ARTITULE/KivoPad/BOM.csv

Item | Qty | Supplier | Cost/item | Total Cost | link
PCB | 1 | JLCPCB | $10.80 | $10.80 | https://jlcpcb.com/
Components from LSCS(Please upload the PCB BOM to their website) | 1 | LSCS | $10.75(Estimated) | $10.75 | https://www.lcsc.com
500mAh Battery | 1 | Amazon | $8.99 | $8.99 | https://www.amazon.com/dp/B0CNLN7F24?_encoding=UTF8&th=1
NRF ProMicro | 1 | Amazon | $7.99 | $7.99 | https://www.amazon.com/NRF52840-Development-Bluetooth-Wireless-Electronics/dp/B0GSZ7FD6T
Estimated total shipping | 1 |  |  | $10.00
Estimated TOTAL |  |  |  | $48.53
