ARTITULE/KivoPad/PCB_FIles/BOM_KivoPad_v1.0.csv

No. | Quantity | Comment | Designator | Footprint | Value | Manufacturer Part | Manufacturer | Supplier Part | Supplier
1 | 4 | 100nF | C1,C2,C3,C4 | C0402 | 100nF | CL05B104KB54PNC | SAMSUNG(三星) | C307331 | LCSC
2 | 16 | 1N4148WS | D1,D2,D3,D4,D5,D6,D7,D8,D9,D10,D11,D12,D13,D14,D15,D16 | SOD-323_L1.8-W1.3-LS2.5-RD |  | 1N4148WS | JSMSEMI(杰盛微) | C917117 | LCSC
3 | 4 | Screw-Hole-M2 | M1,M2,M3,M4 | Screw-Hole-M2
4 | 3 | Screw-Hole-M3 | M5,M6,M7 | Screw-Hole-M3
5 | 4 | 5.1kΩ | R1,R2,R3,R4 | R0402 | 5.1kΩ | 0402WGF5101TCE | UNI-ROYAL(厚声) | C25905 | LCSC
6 | 1 | KMR221GLFS | SW1 | KEY-SMD_KMR2XXGXXX |  | KMR221GLFS | C&K | C72443 | LCSC
7 | 1 | JS202011SCQN | SW2 | SW-SMD_JS202011SCQN |  | JS202011SCQN | C&K | C221666 | LCSC
8 | 2 | EC11E15244B2 | SW3,SW4 | SW-TH_EC11XXXXXXXX |  | EC11E15244B2 | ALPSALPINE(阿尔卑斯阿尔派) | C470754 | LCSC
9 | 1 | NRF_ProMicro | U1 | NRF_Pro_Micro
10 | 14 | CPG151101D13 | U2,U3,U4,U5,U10,U11,U12,U13,U18,U19,U20,U21,U26,U27 | KEY-TH_CPG151101D21X |  | CPG151101D13 | HanElectricity(瀚源) | C49234235 | LCSC
11 | 14 | CPG151101S11-2 | U6,U7,U8,U9,U14,U15,U16,U17,U22,U23,U24,U25,U28,U29 | TH_L10.9-W5.9-CPG151101S11-2 |  | CPG151101S11-2 | HanElectricity(瀚源) | C49352235 | LCSC
12 | 2 | Pad 2mmx4mm | U100,U101 | Pad2mmx4mm
