ARTITULE/KivoPad/3D_Files/Shell_v1.0.3mf

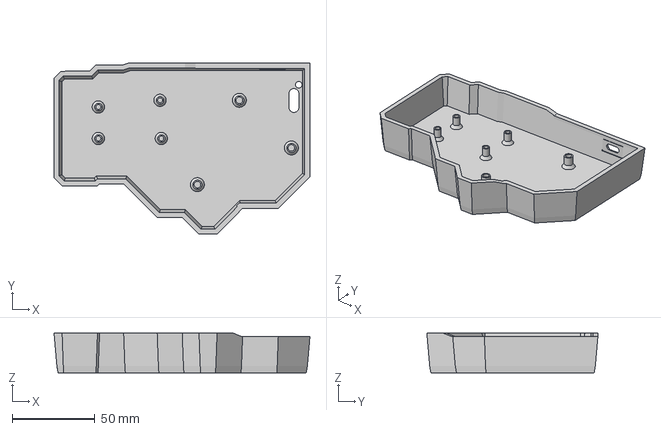
[picture p5: CAD file, 2026-11-08]
3D_Files/Shell_v1.0.3mf
154.9 x 103.7 x 24.0 mm
