ARTITULE/KivoPad/3D_Files/KivoPad_v1.0.step

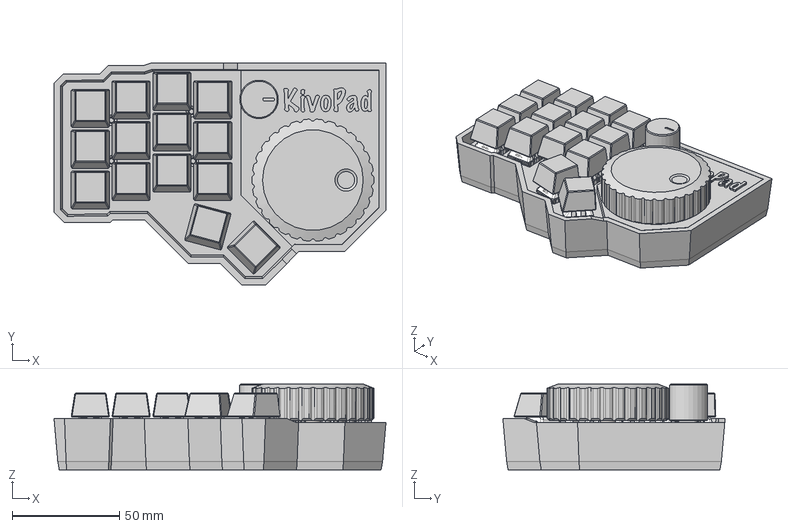
[picture p6: CAD file, 2026-11-08]
3D_Files/KivoPad_v1.0.step
154.9 x 103.7 x 40.1 mm
