ARTITULE/KivoPad/3D_Files/Big_Knob_v1.0.3mf

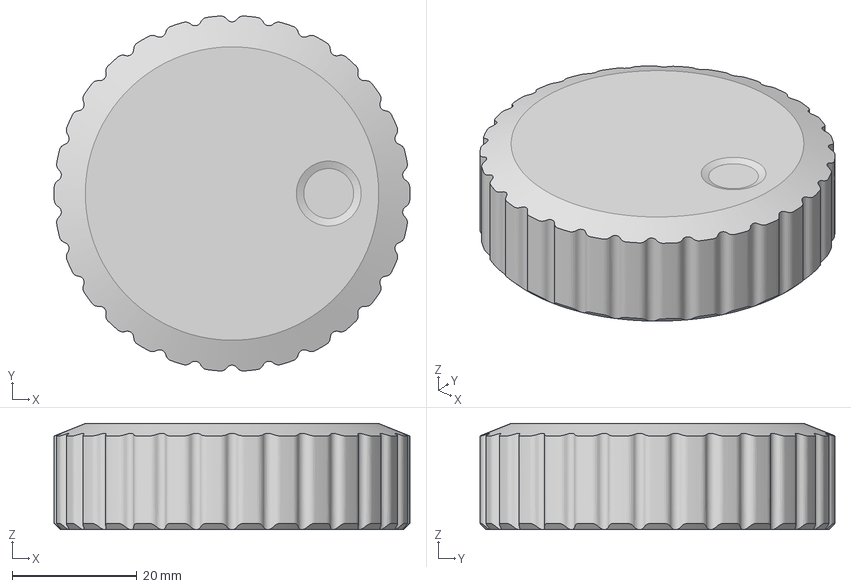
[picture p7: CAD file, 2026-11-08]
3D_Files/Big_Knob_v1.0.3mf
57.0 x 56.9 x 17.0 mm
