ARTITULE/KivoPad/3D_Files/Small_Knob_v1.0.3mf

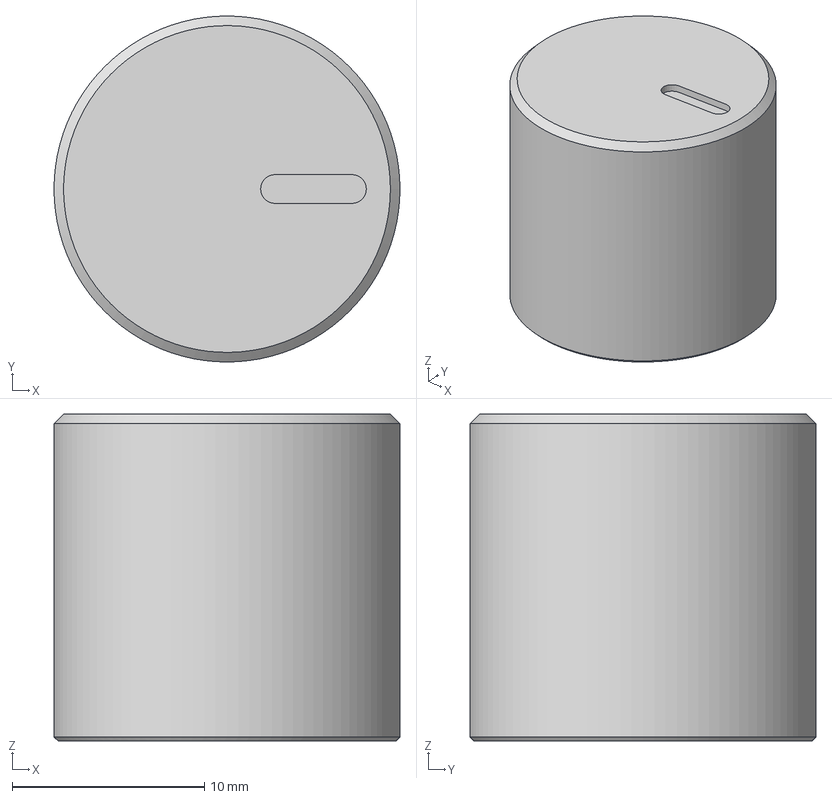
[picture p8: CAD file, 2026-11-08]
3D_Files/Small_Knob_v1.0.3mf
18.0 x 18.0 x 17.0 mm
