ARTITULE/KivoPad/3D_Files/Top_Half_V1.0.3mf

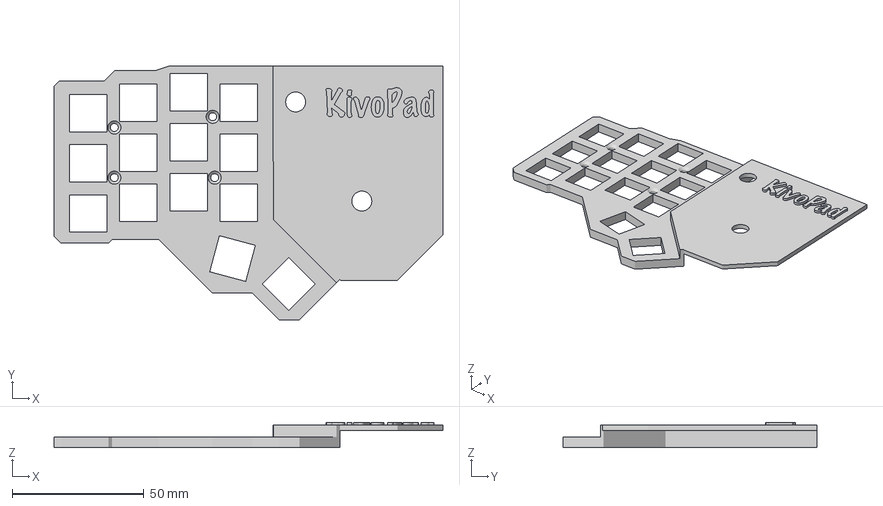
[picture p9: CAD file, 2026-11-08]
3D_Files/Top_Half_V1.0.3mf
147.7 x 96.4 x 9.50 mm
