ARTITULE/KivoPad/(list of files, cad)

Other CAD files:
3D_Files/KivoPad_v1.0.3mf
3D_Files/KivoPad_v1.0.f3z
