ARTITULE/KivoPad/PCB_FIles/SCH_Schematic1_2026-11-08.pdf

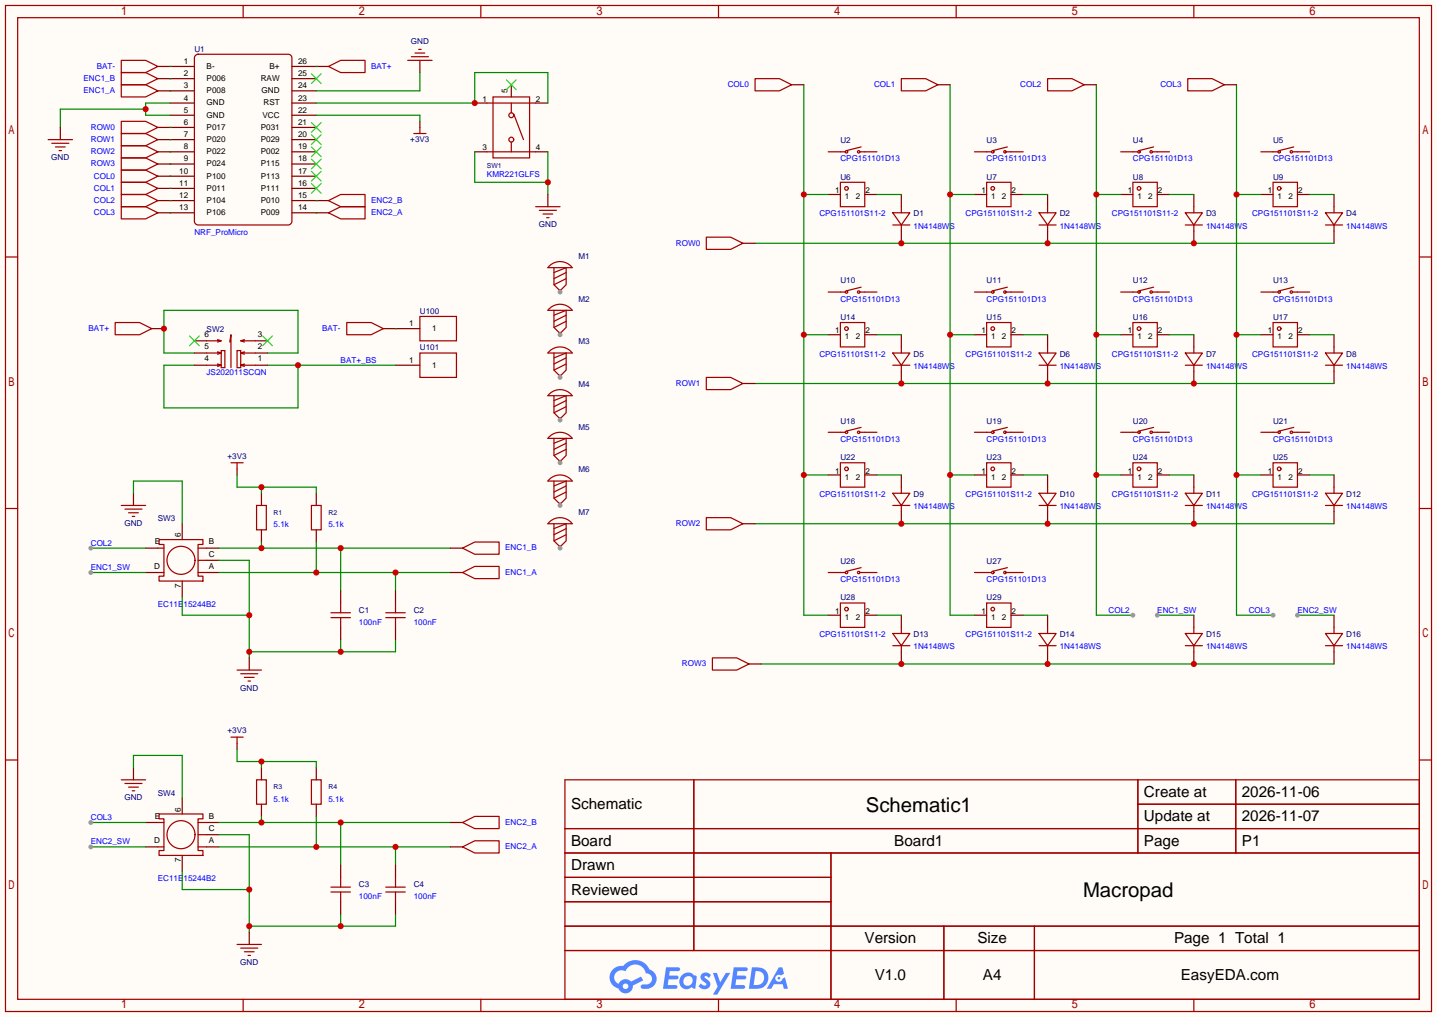
[picture p10: page 1]

Schematic | Schematic1 | Create at | 2026-11-06

Update at | 2026-11-07

Board | Board1 | Page | P1
Drawn | | Macropad
Reviewed

Version | Size | Page 1 Total 1
V1.0 | A4 | EasyEDA.com
