ARTITULE/KivoPad/(list of files, drawings)

Other design files:
PCB_FIles/P1.schdoc
