ARTITULE/KivoPad/JOURNAL.md

# KivoPad: devlog

<!-- Generated by Half Life from project i39eydl9hyu27sn218qils8q. Edits here are overwritten on the next sync. -->
<!-- Generated: 2026-11-08T16:51:52.404Z -->

> [!NOTE]
> This devlog is mirrored from [Half Life](https://halflife.hackclub.com) ([open the project](https://halflife.hackclub.com/projects/i39eydl9hyu27sn218qils8q)). Editing it here will not change the platform's copy, and the next sync overwrites this file.

> KivoPad is a custom macropad running on ZMK firmware featuring 14 mechanical switches with hot-swap sockets and  2 encoders. The switches can be programmed to any action and thanks to ZMK the whole macropad is wireless.

| Week | Tier | Hours logged | Entries |
| --- | --- | --- | --- |
| Week 5 | Tier 1 | 9.68h | 3 |

## Contents

1. [2026-11-07: First entry,](#2026-11-07-first-entry)
2. [2026-11-08: Second entry,](#2026-11-08-second-entry)
3. [2026-11-08: Third entry,](#2026-11-08-third-entry)

## Design

### 2026-11-07: First entry,

**5.68h**

First entry,

Started by creating a new project and finding all of the needed components on LCSC. After that created the microcontroller design and footprint, found and added the 3D model. Laid out the schematic and connected everything. After that transferred everything into the PCB editor and placed the components in the needed places. After that routed the board. Added some text and project link to the PCB and that's it!

[Timelapse](https://lookout.hackclub.com/api/media/dc5bc019-efae-4d72-a863-5ea82e6535f9/video.mp4)

### 2026-11-08: Second entry,

**3.75h**

Second entry,

Started by creating a new project in Fusion. Imported the PCB .step file and stated the case design. Made the outer case, added the switch holder, encoder holes, encoder knobs and the lid. Finished the case with heatset  insert spots and microcontroller type-c cutout.

And that's it!

[Timelapse](https://lookout.hackclub.com/api/media/c7332228-48d9-4f65-b1fb-7eca3833b295/video.mp4)

### 2026-11-08: Third entry,

**0.25h**

Third entry,

Started by fixing the microcontroller 3D file placement. After that exported the Gerber, Pick and Place, PCB BOM, PCB image, PCB 3D image, Schematic in PDF and SVG, Altium designer files including the project and the Schematic and the main project file.

And that's it!

[Timelapse](https://lookout.hackclub.com/api/media/78db496b-c6e2-4e76-9e85-6fad34fdc718/video.mp4)
