ARTITULE/KivoPad/(commit log)

2026-11-08 Configure KivoPad matrix and encoders
2026-11-08 Fix nice nano v2 board target
2026-11-08 Add PCB files
    [BOM_KivoPad_v1.0.csv, P1.schdoc, PickAndPlace_KivoPad_v1_0.xlsx]
2026-11-08 Add 3D files
    [Big_Knob_v1.0.3mf, KivoPad_v1.0.3mf, KivoPad_v1.0.f3z, KivoPad_v1.0.step, Shell_v1.0.3mf, Small_Knob_v1.0.3mf, Top_Half_V1.0.3mf]
2026-11-08 Update README to add 3D Case section
2026-11-08 Sync KivoPad from Half Life
    [BOM.csv]
2026-11-08 Update BOM and README to include BOM :)
    [BOM.csv]
